timhawes/onyx_robot/onyx_robot.pdf

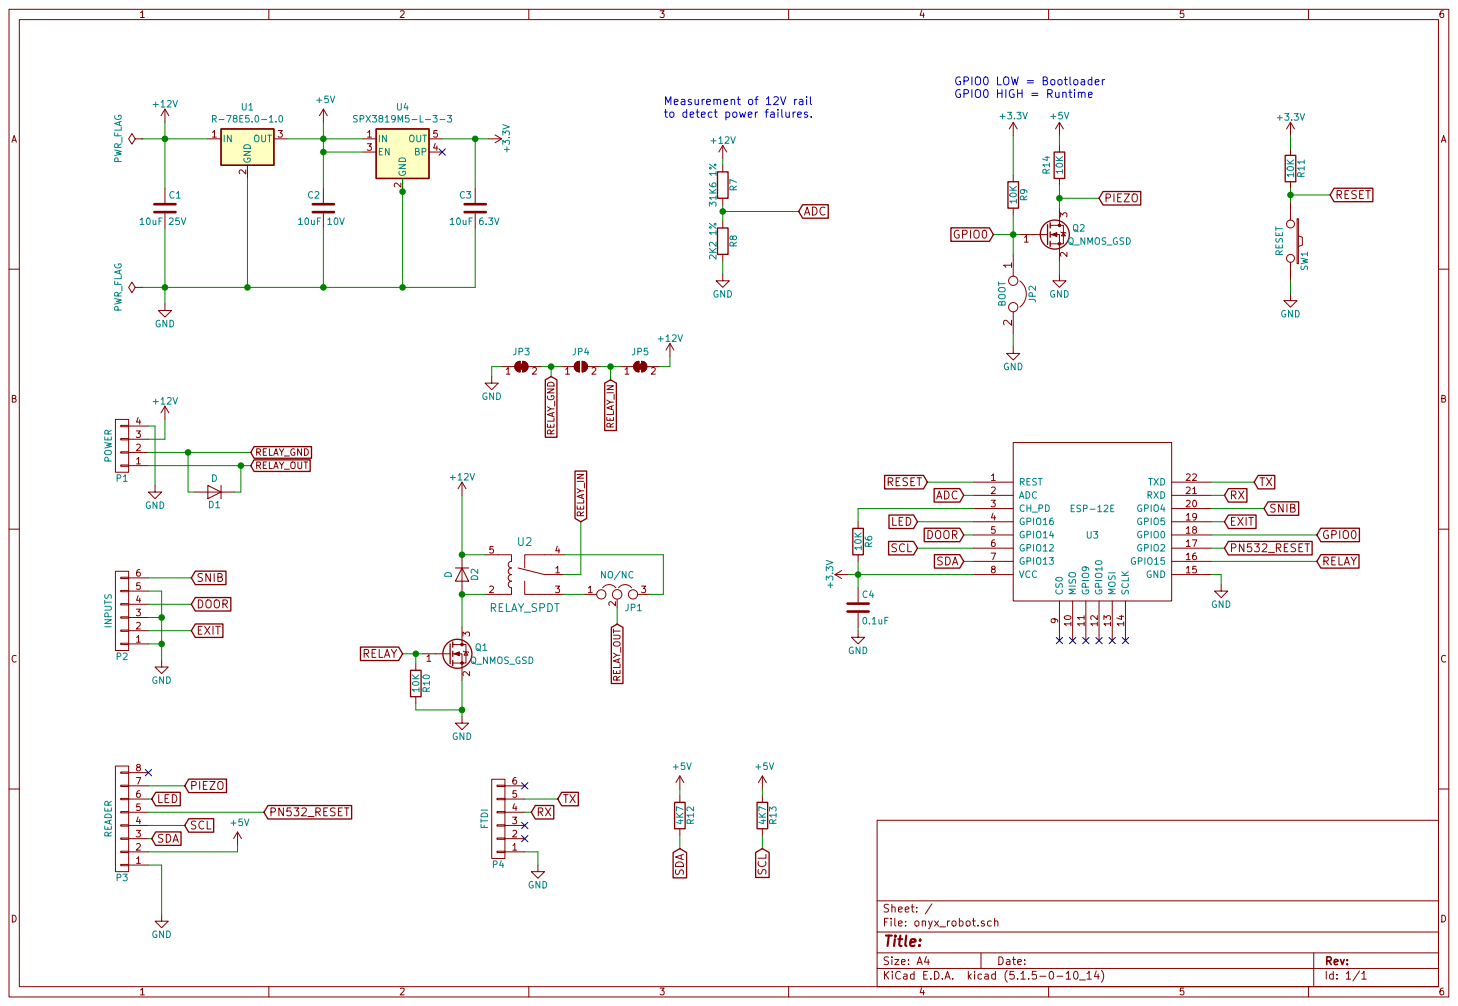
[picture p1: page 1]

to detect power failures.
