timhawes/onyx_robot/onyx_robot.kicad_pcb

## KiCad design onyx_robot.kicad_pcb (2020-07-18)

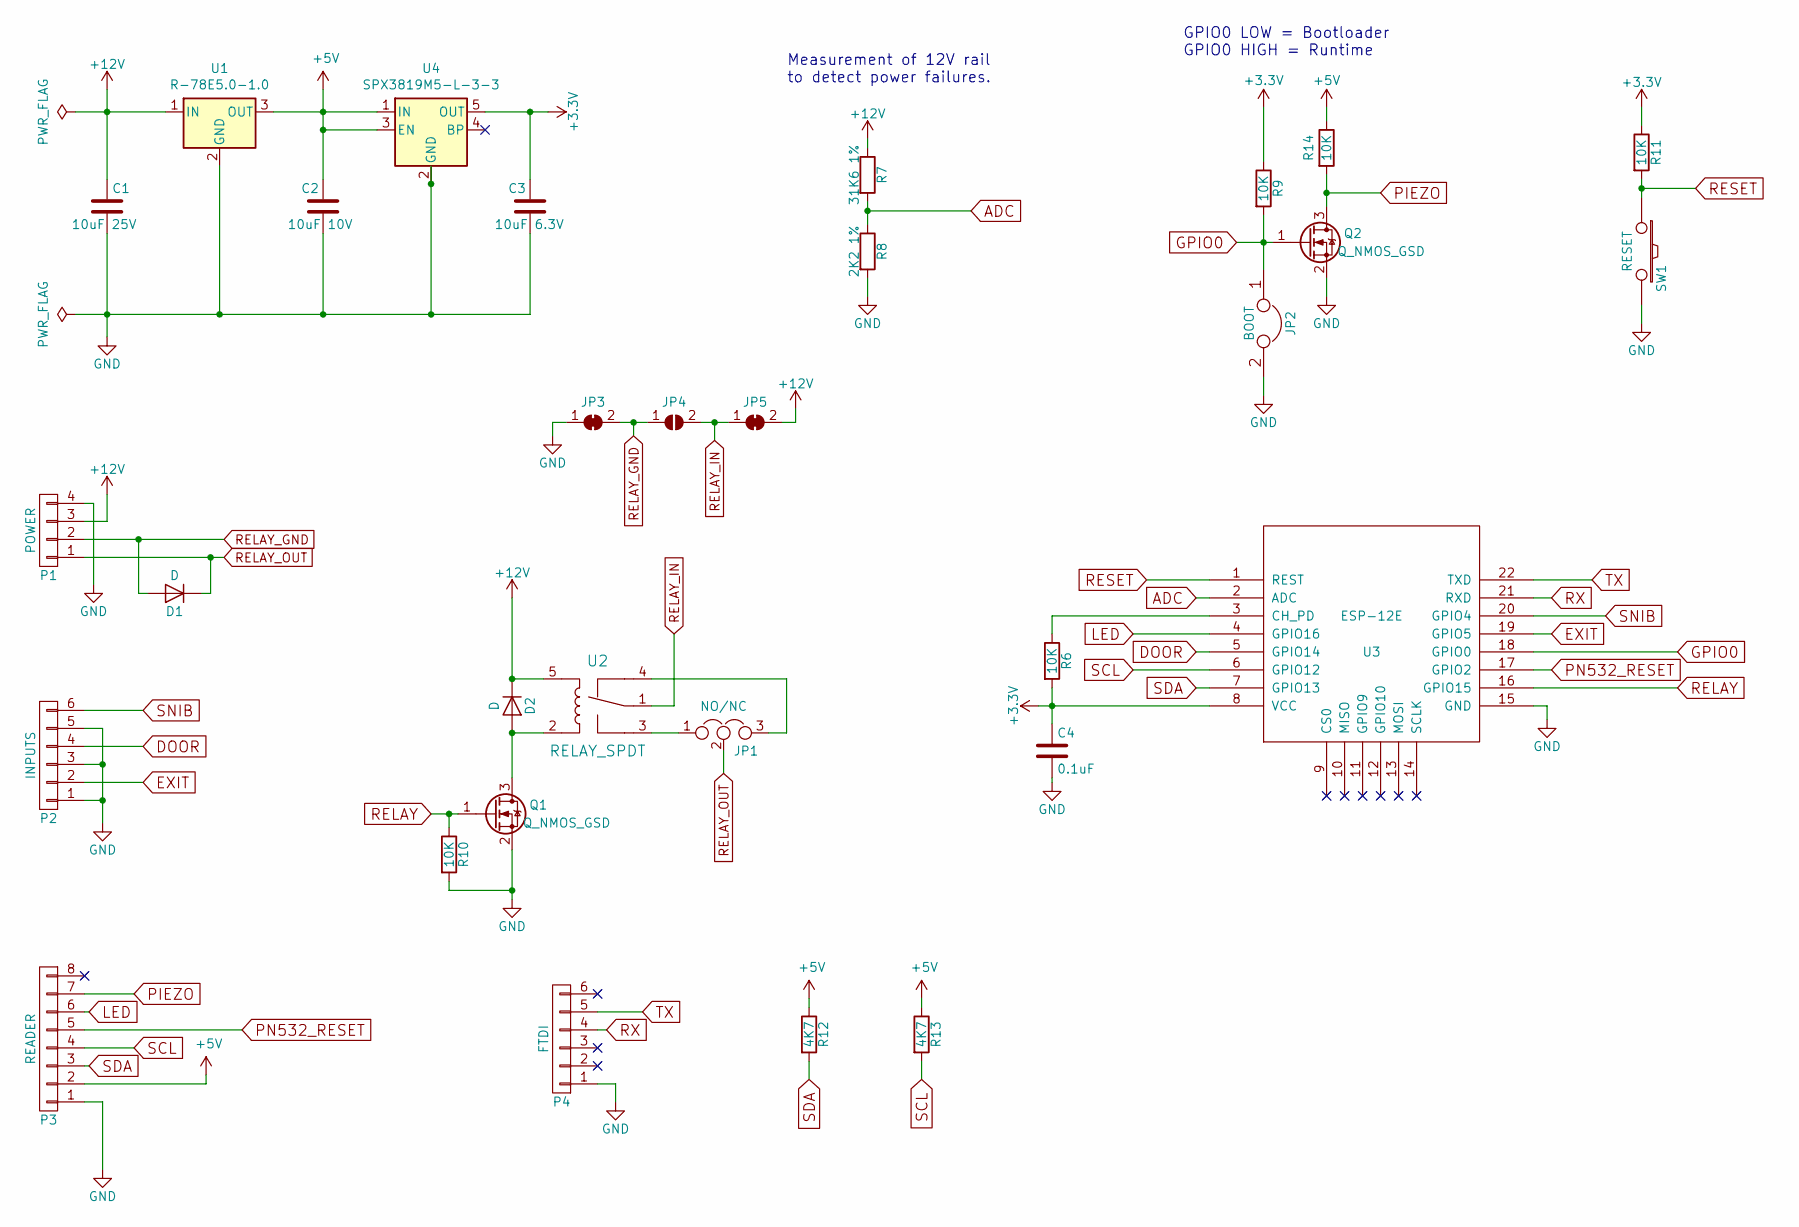
[picture p2: schematic onyx_robot.sch]

Parts:
C1: 10uF 25V; C_0805_2012Metric
C2: 10uF 10V; C_0805_2012Metric
C3: 10uF 6.3V; C_0805_2012Metric
C4: 0.1uF; C_0603_1608Metric
D1, D2: D; D_SMA
JP1: NO/NC; PinHeader_1x03_P2.54mm_Vertical
JP2: BOOT; PinHeader_1x02_P2.54mm_Vertical
JP3, JP5: SolderJumper_2_Bridged; SolderJumper-2_P1.3mm_Bridged_RoundedPad1.0x1.5mm
JP4: SolderJumper_2_Open; SolderJumper-2_P1.3mm_Open_RoundedPad1.0x1.5mm
P1: POWER; Terminal_Block_5.08mm_x4
P2: INPUTS; Terminal_Block_5.08mm_x6
P3: READER; Terminal_Block_5.08mm_x8
P4: FTDI; Pin_Header_Straight_1x06
Q1, Q2: Q_NMOS_GSD; SOT-23
R6, R9, R10, R11, R14: 10K; R_0603_1608Metric
R7: 31K6 1%; R_0603_1608Metric
R8: 2K2 1%; R_0603_1608Metric
R12, R13: 4K7; R_0603_1608Metric
SW1: RESET; EVQPT5
U1: R-78E5.0-1.0; Converter_DCDC_RECOM_R-78E-0.5_THT
U2: RELAY_SPDT; JS_RELAY
U3: ESP-12E
U4: SPX3819M5-L-3-3; SOT-23-5

Connections:
+3V3: C3.1, C4.1, R6.2, R9.1, R11.1, U3.8 (VCC), U4.5 (OUT)
+5V: C2.1, P3.2, R12.1, R13.1, R14.1, U1.3 (OUT), U4.1 (IN), U4.3 (EN)
+12V: C1.1, D2.1 (K), JP5.2 (B), P1.3, R7.1, U1.1 (IN), U2.5
ADC: R7.2, R8.1, U3.2 (ADC)
DOOR: P2.4, U3.5 (GPIO14)
EXIT: P2.2, U3.19 (GPIO5)
GND: C1.2, C2.2, C3.2, C4.2, JP2.2, JP3.1 (A), P1.4, P2.1, P2.3, P2.5, P3.1, P4.1, Q1.2 (S), Q2.2 (S), R8.2, R10.2, SW1.2, U1.2 (GND), U3.15 (GND), U4.2 (GND)
GPIO0: JP2.1, Q2.1 (G), R9.2, U3.18 (GPIO0)
LED: P3.6, U3.4 (GPIO16)
unnamed: D2.2 (A), Q1.3 (D), U2.2
unnamed: JP1.1, U2.3
unnamed: JP1.3, U2.4
unnamed: R6.1, U3.3 (CH_PD)
PIEZO: P3.7, Q2.3 (D), R14.2
PN532_RESET: P3.5, U3.17 (GPIO2)
RELAY: Q1.1 (G), R10.1, U3.16 (GPIO15)
RELAY_GND: D1.2 (A), JP3.2 (B), JP4.1 (A), P1.2
RELAY_IN: JP4.2 (B), JP5.1 (A), U2.1
RELAY_OUT: D1.1 (K), JP1.2, P1.1
RESET: R11.2, SW1.1, U3.1 (REST)
RX: P4.4, U3.21 (RXD)
SCL: P3.4, R13.2, U3.6 (GPIO12)
SDA: P3.3, R12.2, U3.7 (GPIO13)
SNIB: P2.6, U3.20 (GPIO4)
TX: P4.5, U3.22 (TXD)

Notes on the sheet:
Measurement of 12V rail to detect power failures.
GPIO0 LOW = Bootloader GPIO0 HIGH = Runtime

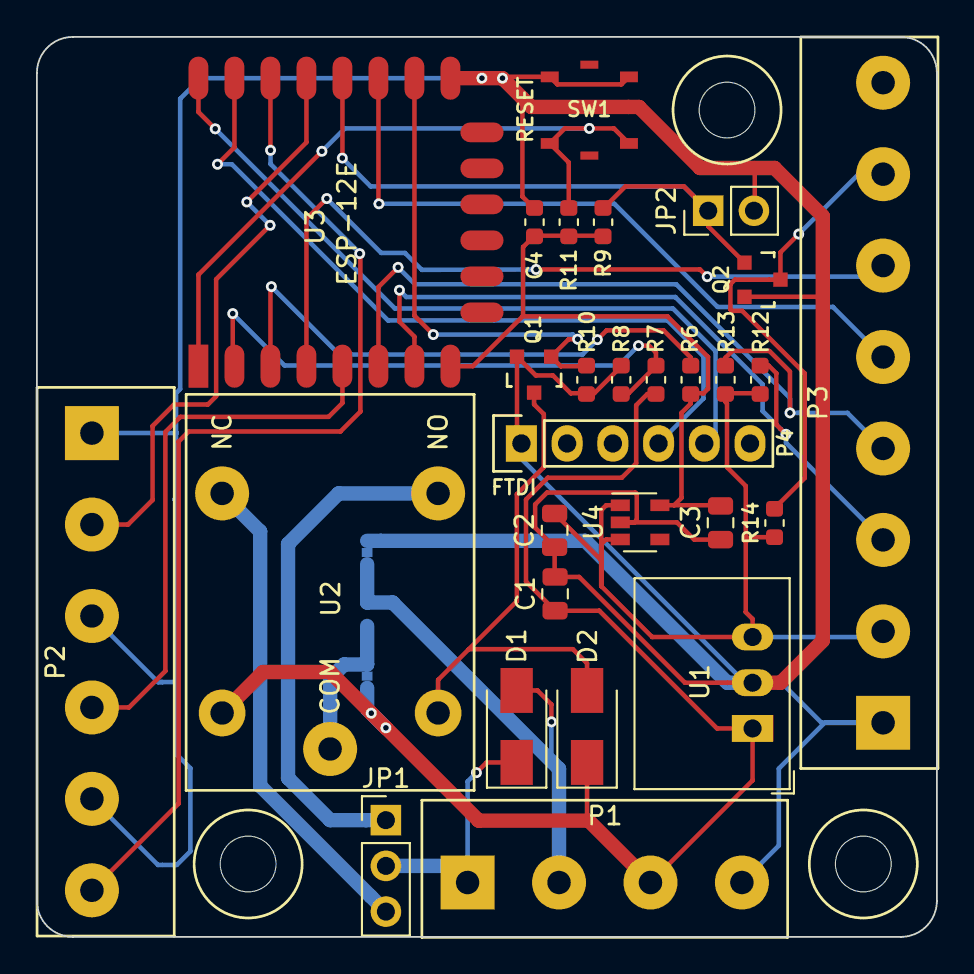
[picture p3: board onyx_robot.kicad_pcb from above]

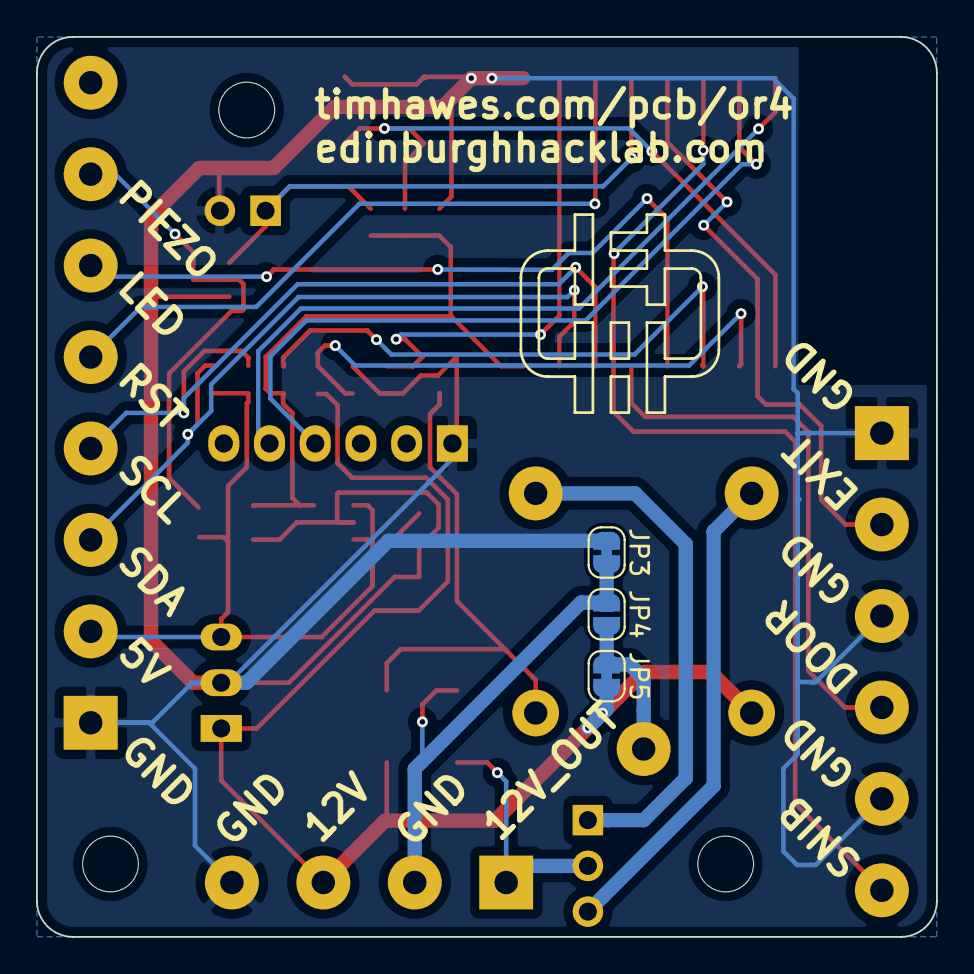
[picture p4: board onyx_robot.kicad_pcb from below]

Board: 2 copper layers, 50.0 x 50.0 mm, 31 parts (3 on the bottom side), 25 nets.
