timhawes/onyx_robot/(commit log)

2015-06-20 Add decoupling capacitor to ESP8266 and optional snib/tamper outputs
    [onyx_robot.sch]
2015-06-20 Option to add more power supply capacitors later
    [onyx_robot.sch]
2015-06-20 Remove stray junction
    [onyx_robot.sch]
2015-06-20 New component for relay, pin numbering consistent with intended footprint
    [onyx_robot.sch]
2015-06-24 Assign footprints
    [onyx_robot.sch]
2015-06-26 FET and jumper added to piezo output Fix to incorrect net connection in power supply Connectors rearranged to 8+6+6 configuration Footprints assigned
    [onyx_robot.sch]
2015-06-27 Move SNIB closer to the ESP
    [onyx_robot.sch]
2015-06-27 Swap 12V in/out connector pins
    [onyx_robot.sch]
2015-06-28 Switch to standard (not hand-soldering) footprints to save space
    [onyx_robot.sch]
2015-06-28 Use corrected ESP-12E footprint
    [onyx_robot.sch]
2015-06-28 Shuffle READER pins to put GND/3.3V together
    [onyx_robot.sch]
2015-06-29 Swap power in/out pins
    [onyx_robot.sch]
2015-06-29 PCB checked-in
    [onyx_robot.kicad_pcb]
2015-06-30 Tidy-ups, increase track size
    [onyx_robot.kicad_pcb]
2015-07-01 Text tidied-up. Relay repositioned to give larger gaps. Mounting holes enlarged.
    [onyx_robot.kicad_pcb]
2015-07-01 Restore FTDI reference text
    [onyx_robot.kicad_pcb]
2015-07-01 Gerbers added
    [onyx_robot-B_Cu.gbl, onyx_robot-B_Mask.gbs, onyx_robot-B_SilkS.gbo, onyx_robot-Edge_Cuts.gbr, onyx_robot-F_Cu.gtl, onyx_robot-F_Mask.gts, onyx_robot-F_SilkS.gto, onyx_robot.drl]
2015-07-01 Clean-up silkscreen labels
    [onyx_robot-B_Cu.gbl, onyx_robot-B_Mask.gbs, onyx_robot-B_SilkS.gbo, onyx_robot-Edge_Cuts.gbr, onyx_robot-F_Cu.gtl, onyx_robot-F_Mask.gts, onyx_robot-F_SilkS.gto, onyx_robot.drl]
2015-07-02 Change MOSFET SOT-23 pin ordering and adjust layout to match
    [onyx_robot-B_Cu.gbl, onyx_robot-B_Mask.gbs, onyx_robot-B_SilkS.gbo, onyx_robot-Edge_Cuts.gbr, onyx_robot-F_Cu.gtl, onyx_robot-F_Mask.gts, onyx_robot-F_SilkS.gto, onyx_robot.drl]
2015-07-03 Increased clearance between Q2 and screw terminals
    [onyx_robot-B_Cu.gbl, onyx_robot-B_Mask.gbs, onyx_robot-B_SilkS.gbo, onyx_robot-Edge_Cuts.gbr, onyx_robot-F_Cu.gtl, onyx_robot-F_Mask.gts, onyx_robot-F_SilkS.gto, onyx_robot.drl]
2015-08-18 Correction to value of R2
    [onyx_robot.sch]
2015-08-18 Change ADC voltage divider to match the 0-1V ADC requirement
    [onyx_robot.sch]
2015-08-18 Swap RX/TX on FTDI header
    [onyx_robot.sch]
2015-08-18 Fix RX/TX in PCB and regenerate all files
    [onyx_robot-B_Cu.gbl, onyx_robot-B_Mask.gbs, onyx_robot-B_SilkS.gbo, onyx_robot-Edge_Cuts.gbr, onyx_robot-F_Cu.gtl, onyx_robot-F_Mask.gts, onyx_robot-F_SilkS.gto, onyx_robot.drl]
2015-08-21 Version 2
    [onyx_robot-B_Cu.gbl, onyx_robot-B_Mask.gbs, onyx_robot-B_SilkS.gbo, onyx_robot-Edge_Cuts.gbr, onyx_robot-F_Cu.gtl, onyx_robot-F_Mask.gts, onyx_robot-F_SilkS.gto, onyx_robot.drl]
2015-08-30 Finished version 2
    [onyx_robot-B_Cu.gbl, onyx_robot-B_Mask.gbs, onyx_robot-B_Paste.gbp, onyx_robot-B_SilkS.gbo, onyx_robot-Edge_Cuts.gbr, onyx_robot-F_Cu.gtl, onyx_robot-F_Paste.gtp, onyx_robot-F_SilkS.gto]
2019-08-02 Revision 3
    Off-the-shelf power supply module
    5V supplied to NFC reader
    Piezo improved
    ESD protection removed to complexity
    NC contact removed from relay
    VCC removed from FTDI connector
    Flyback diode added to relay output
    [onyx_robot-B_Cu.gbl, onyx_robot-B_Mask.gbs, onyx_robot-B_Paste.gbp, onyx_robot-B_SilkS.gbo, onyx_robot-Edge_Cuts.gm1, onyx_robot-F_Cu.gtl, onyx_robot-F_Mask.gts, onyx_robot-F_Paste.gtp]
2019-09-21 Changes to text
    [onyx_robot-B_Cu.gbl, onyx_robot-B_Mask.gbs, onyx_robot-B_Paste.gbp, onyx_robot-B_SilkS.gbo, onyx_robot-Edge_Cuts.gm1, onyx_robot-F_Cu.gtl, onyx_robot-F_Mask.gts, onyx_robot-F_Paste.gtp]
2020-07-13 Revision 4
    [onyx_robot-B_Cu.gbl, onyx_robot-B_Mask.gbs, onyx_robot-B_Paste.gbp, onyx_robot-B_SilkS.gbo, onyx_robot-Edge_Cuts.gm1, onyx_robot-F_Cu.gtl, onyx_robot-F_Mask.gts, onyx_robot-F_Paste.gtp]
2020-07-18 No volt relay option
    [onyx_robot-B_Cu.gbl, onyx_robot-B_Mask.gbs, onyx_robot-B_Paste.gbp, onyx_robot-B_SilkS.gbo, onyx_robot-Edge_Cuts.gm1, onyx_robot-F_Cu.gtl, onyx_robot-F_Mask.gts, onyx_robot-F_Paste.gtp]
